LordsBoards/KiCad_Jobset_Example/README.md

# An KiCad 9 jobset example, based on an STM32U585 Pro Micro

<p align="center">
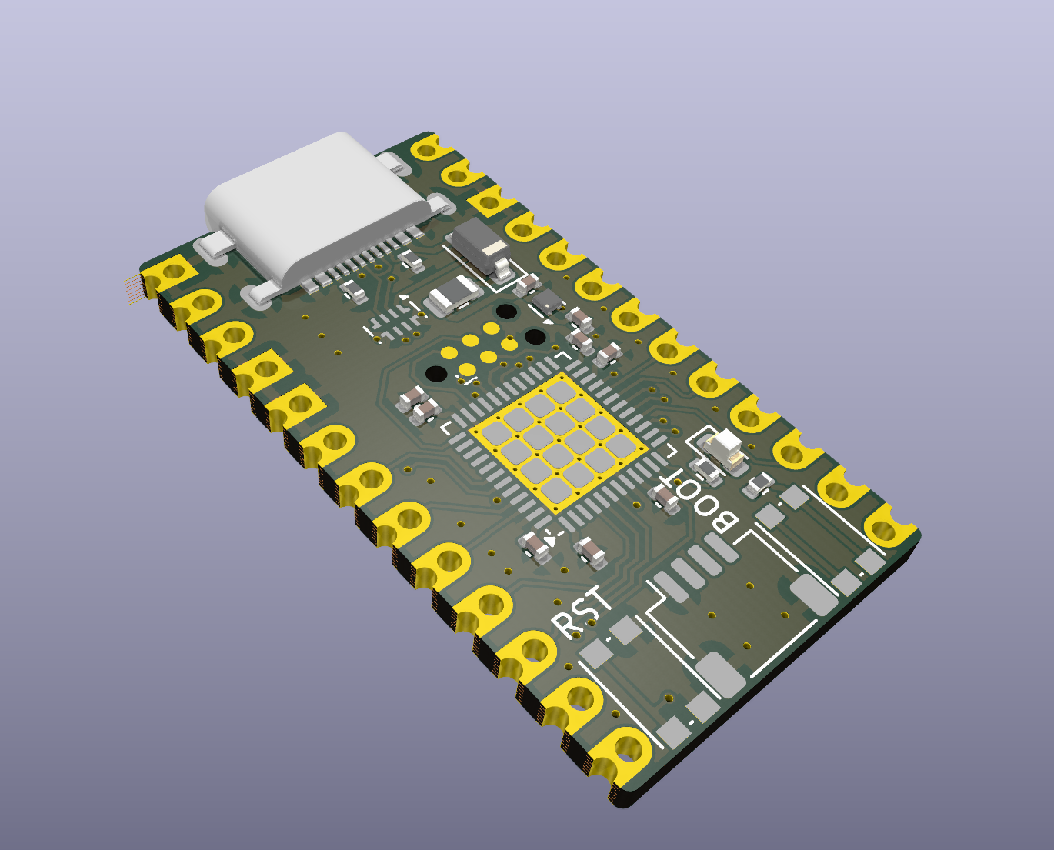
[picture p1: img/promicro.png]
Pro Micro
  
</p>

To use this jobset template, copy it to your project directory and click "File > Open Jobset File..."
