LordsBoards/KiCad_Jobset_Example/STM32U585_ProMicro.kicad_pcb

## KiCad design STM32U585_ProMicro.kicad_pcb (2025-04-02)

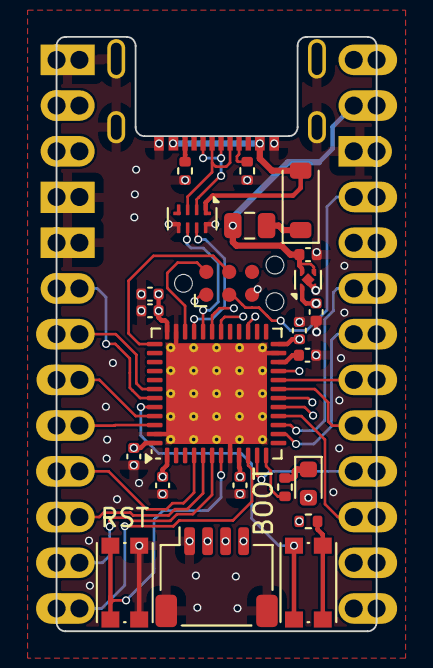
[picture p2: board STM32U585_ProMicro.kicad_pcb from above]

Board: 8 copper layers, 17.8 x 33.0 mm, 25 parts (0 on the bottom side), 39 nets.

Parts:
C1, C2: 1uF; C_0402_1005Metric
C3, C4, C5, C6, C8: 100nF; C_0402_1005Metric
C7: 4.7uF; C_0402_1005Metric
C9: 10uF; C_0402_1005Metric
D1: LED_Small; LED_0603_1608Metric
D2: D_Small; D_SOD-123
F1: Polyfuse_Small; Fuse_0805_2012Metric
J1: Conn_ARM_SWD_TagConnect_TC2030-NL; Tag-Connect_TC2030-IDC-NL_2x03_P1.27mm_Vertical
J2: Conn_01x04_MountingPin; JST_SH_SM04B-SRSS-TB_1x04-1MP_P1.00mm_Horizontal
J3: USB_C_Receptacle_USB2.0_16P; USB_C_Receptacle_Jing_918-418K2024S40000
J102: Conn_02x13_Top_Bottom; Connector_Pro_Micro_Castellated
R1, R2, R4: 5.1kR; R_0402_1005Metric
R3: 220R; R_0402_1005Metric
SW1, SW2: SW_Push; SW_Push_1P1T_NO_CK_KMR2
U1: STM32U585CIUx; QFN-48-1EP_7x7mm_P0.5mm_EP5.6x5.6mm_ThermalVias
U2: NCP115AMX250TCG; OnSemi_XDFN4-1EP_1.0x1.0mm_EP0.52x0.52mm
U4: ECMF02-4CMX8; ST_UQFN-8L_1.2x2.5mm_P0.5mm

Connections:
+3.3V: C2.1, C3.1, C4.1, C5.1, C6.1, C8.1, C9.1, D1.2 (A), J1.1 (VCC), J2.2, J102.18, R4.1, U1.1 (VBAT), U1.9 (VDDA), U1.24 (VDD), U1.36 (VDD), U1.48 (VDD), U2.1 (OUT)
/BOOT0: SW1.1, U1.44 (PH3)
/D0/RX: J102.3, U1.31 (USART1_RX)
/D1/TX: J102.2, U1.30 (USART1_TX)
/D2/SDA: J102.6, U1.43 (I2C1_SDA)
/D3/SCL: J102.7, U1.42 (I2C1_SCL)
/D4/CAN_RX: J102.8, U1.45 (FDCAN1_RX)
/D5/CAN_TX: J102.9, U1.46 (FDCAN1_TX)
/D6: J102.10, U1.4 (PC15)
/D7: J102.11, U1.5 (PH0)
/D8: J102.12, U1.6 (PH1)
/D9: J102.13, U1.10 (PA0)
/D10: J102.26, U1.18 (PB0)
/D14/MISO: J102.24, U1.16 (SPI1_MISO)
/D15/SCLK: J102.23, U1.11 (SPI1_SCK)
/D16/MOSI: J102.25, U1.17 (SPI1_MOSI)
/D18: J102.22, U1.19 (PB1)
/D19: J102.21, U1.20 (PB2)
/D20: J102.20, U1.14 (PA4)
/D21: J102.19, U1.15 (PA5)
/LED: R3.2, U1.12 (PA2)
/SCL_QWIIC: J2.4, U1.21 (I2C2_SCL)
/SDA_QWIIC: J2.3, U1.27 (I2C2_SDA)
/SWCLK: J1.4 (SWCLK), U1.37 (DEBUG_JTCK-SWCLK)
/SWDIO: J1.2 (SWDIO), U1.34 (DEBUG_JTMS-SWDIO)
/USB_D+: J3.A6 (D+), J3.B6 (D+), U4.2 (D-_in)
/USB_D-: J3.A7 (D-), J3.B7 (D-), U4.3 (D+_in)
/USB_DN: U1.32 (USB_OTG_FS_DM), U4.6 (D+_out)
/USB_DP: U1.33 (USB_OTG_FS_DP), U4.7 (D-_out)
/~RST: J1.3 (~RESET), J102.17, SW2.1, U1.7 (NRST)
GND: C1.2, C2.2, C3.2, C4.2, C5.2, C6.2, C7.2, C8.2, C9.2, J1.5 (GND), J2.1, J2.MP (MountPin), J3.A1 (GND), J3.S1 (SHIELD), J102.1, J102.4, J102.5, J102.16, R1.2, R2.2, SW2.2, U1.8 (VSSA), U1.23 (VSS), U1.35 (VSS), U1.47 (VSS), U1.49 (VSS), U2.2 (GND), U2.5 (GND), U4.5 (GND), U4.8 (GND)
unnamed: D1.1 (K), R3.1
unnamed: D2.2 (A), J3.A4 (VBUS), U4.1 (VBUS)
unnamed: D2.1 (K), F1.1
unnamed: J3.A5 (CC1), R1.1
unnamed: J3.B5 (CC2), R2.1
unnamed: R4.2, SW1.2
unnamed: C7.1, U1.22 (VCAP)
VBUS: C1.1, F1.2, J102.15, U2.3 (EN), U2.4 (IN)
